someonelse20/Simple-FC/production/BOM.csv

Reference | Qty | Value | DNP | Exclude from BOM | Exclude from Board | Exclude from Simulation | Exclude from Position Files | Footprint | Datasheet | MPN
SW1 | 1 | SW_Push |  |  |  |  | ${EXCLUDE_FROM_POS_FILES} | Button_Switch_SMD:SW_Push_SPST_NO_Alps_SKRK |  | SKRKAEE020
C1,C2 | 2 | 33pF |  |  |  |  | ${EXCLUDE_FROM_POS_FILES} | Capacitor_SMD:C_0402_1005Metric |  | CL05C330JB5NNNC
C4,C10,C26,C28,C29 | 5 | 4.7uF |  |  |  |  | ${EXCLUDE_FROM_POS_FILES} | Capacitor_SMD:C_0402_1005Metric |  | GRM155R60J475ME47D
C5,C6,C7,C8,C9,C11,C12,C13,C14,C15,C16,C17,C18,C22,C23 | 15 | 0.1uF |  |  |  |  | ${EXCLUDE_FROM_POS_FILES} | Capacitor_SMD:C_0402_1005Metric |  | GRM155R71H104KE14D
C20,C21 | 2 | 1uF |  |  |  |  | ${EXCLUDE_FROM_POS_FILES} | Capacitor_SMD:C_0402_1005Metric |  | CL05A105KO5NNNC
C19 | 1 | 10uF |  |  |  |  | ${EXCLUDE_FROM_POS_FILES} | Capacitor_SMD:C_0603_1608Metric |  | GRM188R61A106ME69D
C24 | 1 | 47uF |  |  |  |  | ${EXCLUDE_FROM_POS_FILES} | Capacitor_SMD:C_0603_1608Metric |  | GRM188R60J476ME15D
C25 | 1 | 22uF |  |  |  |  | ${EXCLUDE_FROM_POS_FILES} | Capacitor_SMD:C_0603_1608Metric |  | C1608X5R0J226M080AC
J2 | 1 | Micro_SD_Card |  |  |  |  | ${EXCLUDE_FROM_POS_FILES} | Connector_Card:microSD_HC_Molex_47219-2001 | https://www.we-online.com/components/products/datasheet/693072010801.pdf | MSD-7-A
J8 | 1 | Conn_01x03 | DNP |  |  |  | ${EXCLUDE_FROM_POS_FILES} | Connector_PinHeader_2.54mm:PinHeader_1x03_P2.54mm_Vertical
J3,J4,J5,J7 | 4 | Conn_01x04 | DNP |  |  |  | ${EXCLUDE_FROM_POS_FILES} | Connector_PinHeader_2.54mm:PinHeader_1x04_P2.54mm_Vertical
J6 | 1 | Conn_01x05 | DNP |  |  |  | ${EXCLUDE_FROM_POS_FILES} | Connector_PinHeader_2.54mm:PinHeader_1x05_P2.54mm_Vertical
J1 | 1 | USB_C_Receptacle_USB2.0_14P |  |  |  |  | ${EXCLUDE_FROM_POS_FILES} | Connector_USB:USB_C_Receptacle_HRO_TYPE-C-31-M-12 | https://www.usb.org/sites/default/files/documents/usb_type-c.zip | UJ20-C-H-G-SMT-1-P16-TR
J9,J10 | 2 | Conn_01x01 | DNP |  |  |  | ${EXCLUDE_FROM_POS_FILES} | Connector_Wire:SolderWirePad_1x01_SMD_1x2mm
Y1 | 1 | 12MHz |  |  |  |  | ${EXCLUDE_FROM_POS_FILES} | Crystal:Crystal_SMD_3225-4Pin_3.2x2.5mm |  | ABM8-272-T3
D1,D2 | 2 | D_Schottky |  |  |  |  | ${EXCLUDE_FROM_POS_FILES} | Diode_SMD:D_SMA |  | SS210A
L1 | 1 | 1uH |  |  |  |  | ${EXCLUDE_FROM_POS_FILES} | Inductor_SMD:L_0805_2012Metric |  | DFE201210U-1R0M=P2
L2 | 1 | 3.3uH |  |  |  |  | ${EXCLUDE_FROM_POS_FILES} | Inductor_SMD:L_0805_2012Metric |  | AOTA-B201610S3R3-101-T
D3,D4 | 2 | LED |  |  |  |  | ${EXCLUDE_FROM_POS_FILES} | LED_SMD:LED_0603_1608Metric |  | LTST-C190GKT,LTST-C190KRKT
U1 | 1 | RP2350A |  |  |  |  | ${EXCLUDE_FROM_POS_FILES} | Package_DFN_QFN:QFN-60-1EP_7x7mm_P0.4mm_EP3.4x3.4mm | https://datasheets.raspberrypi.com/rp2350/rp2350-datasheet.pdf | RP2350A
U3 | 1 | LSM6DSM |  |  |  |  | ${EXCLUDE_FROM_POS_FILES} | Package_LGA:LGA-14_3x2.5mm_P0.5mm_LayoutBorder3x4y | https://www.st.com/resource/en/datasheet/lsm6dsm.pdf | LSM6DSMTR
U2 | 1 | MMC5983MA |  |  |  |  | ${EXCLUDE_FROM_POS_FILES} | Package_LGA:LGA-16_3x3mm_P0.5mm | https://www.memsic.com/Public/Uploads/uploadfile/files/20220119/MMC5983MADatasheetRevA.pdf | MMC5983MA
U4 | 1 | BMP384 |  |  |  |  | ${EXCLUDE_FROM_POS_FILES} | Package_LGA:ST_HLGA-10_2x2mm_P0.5mm_LayoutBorder3x2y | https://www.bosch-sensortec.com/media/boschsensortec/downloads/datasheets/bst-bmp384-ds003.pdf | BMP384
U6 | 1 | W25Q128JVS |  |  |  |  | ${EXCLUDE_FROM_POS_FILES} | Package_SON:Winbond_USON-8-1EP_3x2mm_P0.5mm_EP0.2x1.6mm | https://www.winbond.com/resource-files/w25q128jv_dtr%20revc%2003272018%20plus.pdf | W25Q128JVSIQ TR
U5 | 1 | TPS631000 |  |  |  |  | ${EXCLUDE_FROM_POS_FILES} | Package_TO_SOT_SMD:SOT-583-8 | https://www.ti.com/lit/ds/symlink/tps631000.pdf | TPS631000DRLR
R1,R2 | 2 | 5.1K |  |  |  |  | ${EXCLUDE_FROM_POS_FILES} | Resistor_SMD:R_0402_1005Metric |  | RC0402FR-075K1L
R3,R5,R20,R21 | 4 | 1K |  |  |  |  | ${EXCLUDE_FROM_POS_FILES} | Resistor_SMD:R_0402_1005Metric |  | ERJ-2RKF1001X
R4,R6,R7,R8,R9,R10,R11 | 7 | 10K |  |  |  |  | ${EXCLUDE_FROM_POS_FILES} | Resistor_SMD:R_0402_1005Metric |  | RC0402FR-0710KL
R12 | 1 | 511K |  |  |  |  | ${EXCLUDE_FROM_POS_FILES} | Resistor_SMD:R_0402_1005Metric |  | RC0402FR-13511KL
R13 | 1 | 91K |  |  |  |  | ${EXCLUDE_FROM_POS_FILES} | Resistor_SMD:R_0402_1005Metric |  | RK73H1ETTP9102F
R14,R16 | 2 | 100K |  |  |  |  | ${EXCLUDE_FROM_POS_FILES} | Resistor_SMD:R_0402_1005Metric |  | RC0402FR-07100KL
R15 | 1 | 33 |  |  |  |  | ${EXCLUDE_FROM_POS_FILES} | Resistor_SMD:R_0402_1005Metric |  | RC0402FR-0733RL
R17 | 1 | 150K |  |  |  |  | ${EXCLUDE_FROM_POS_FILES} | Resistor_SMD:R_0402_1005Metric |  | CPF0402B150KE1
R18,R19 | 2 | 4.7K |  |  |  |  | ${EXCLUDE_FROM_POS_FILES} | Resistor_SMD:R_0402_1005Metric |  | RK73H1ETTP4701F
