someonelse20/Simple-FC/hardware/Simple-FC.kicad_pcb

## KiCad design hardware/Simple-FC.kicad_pcb (2026-11-06)

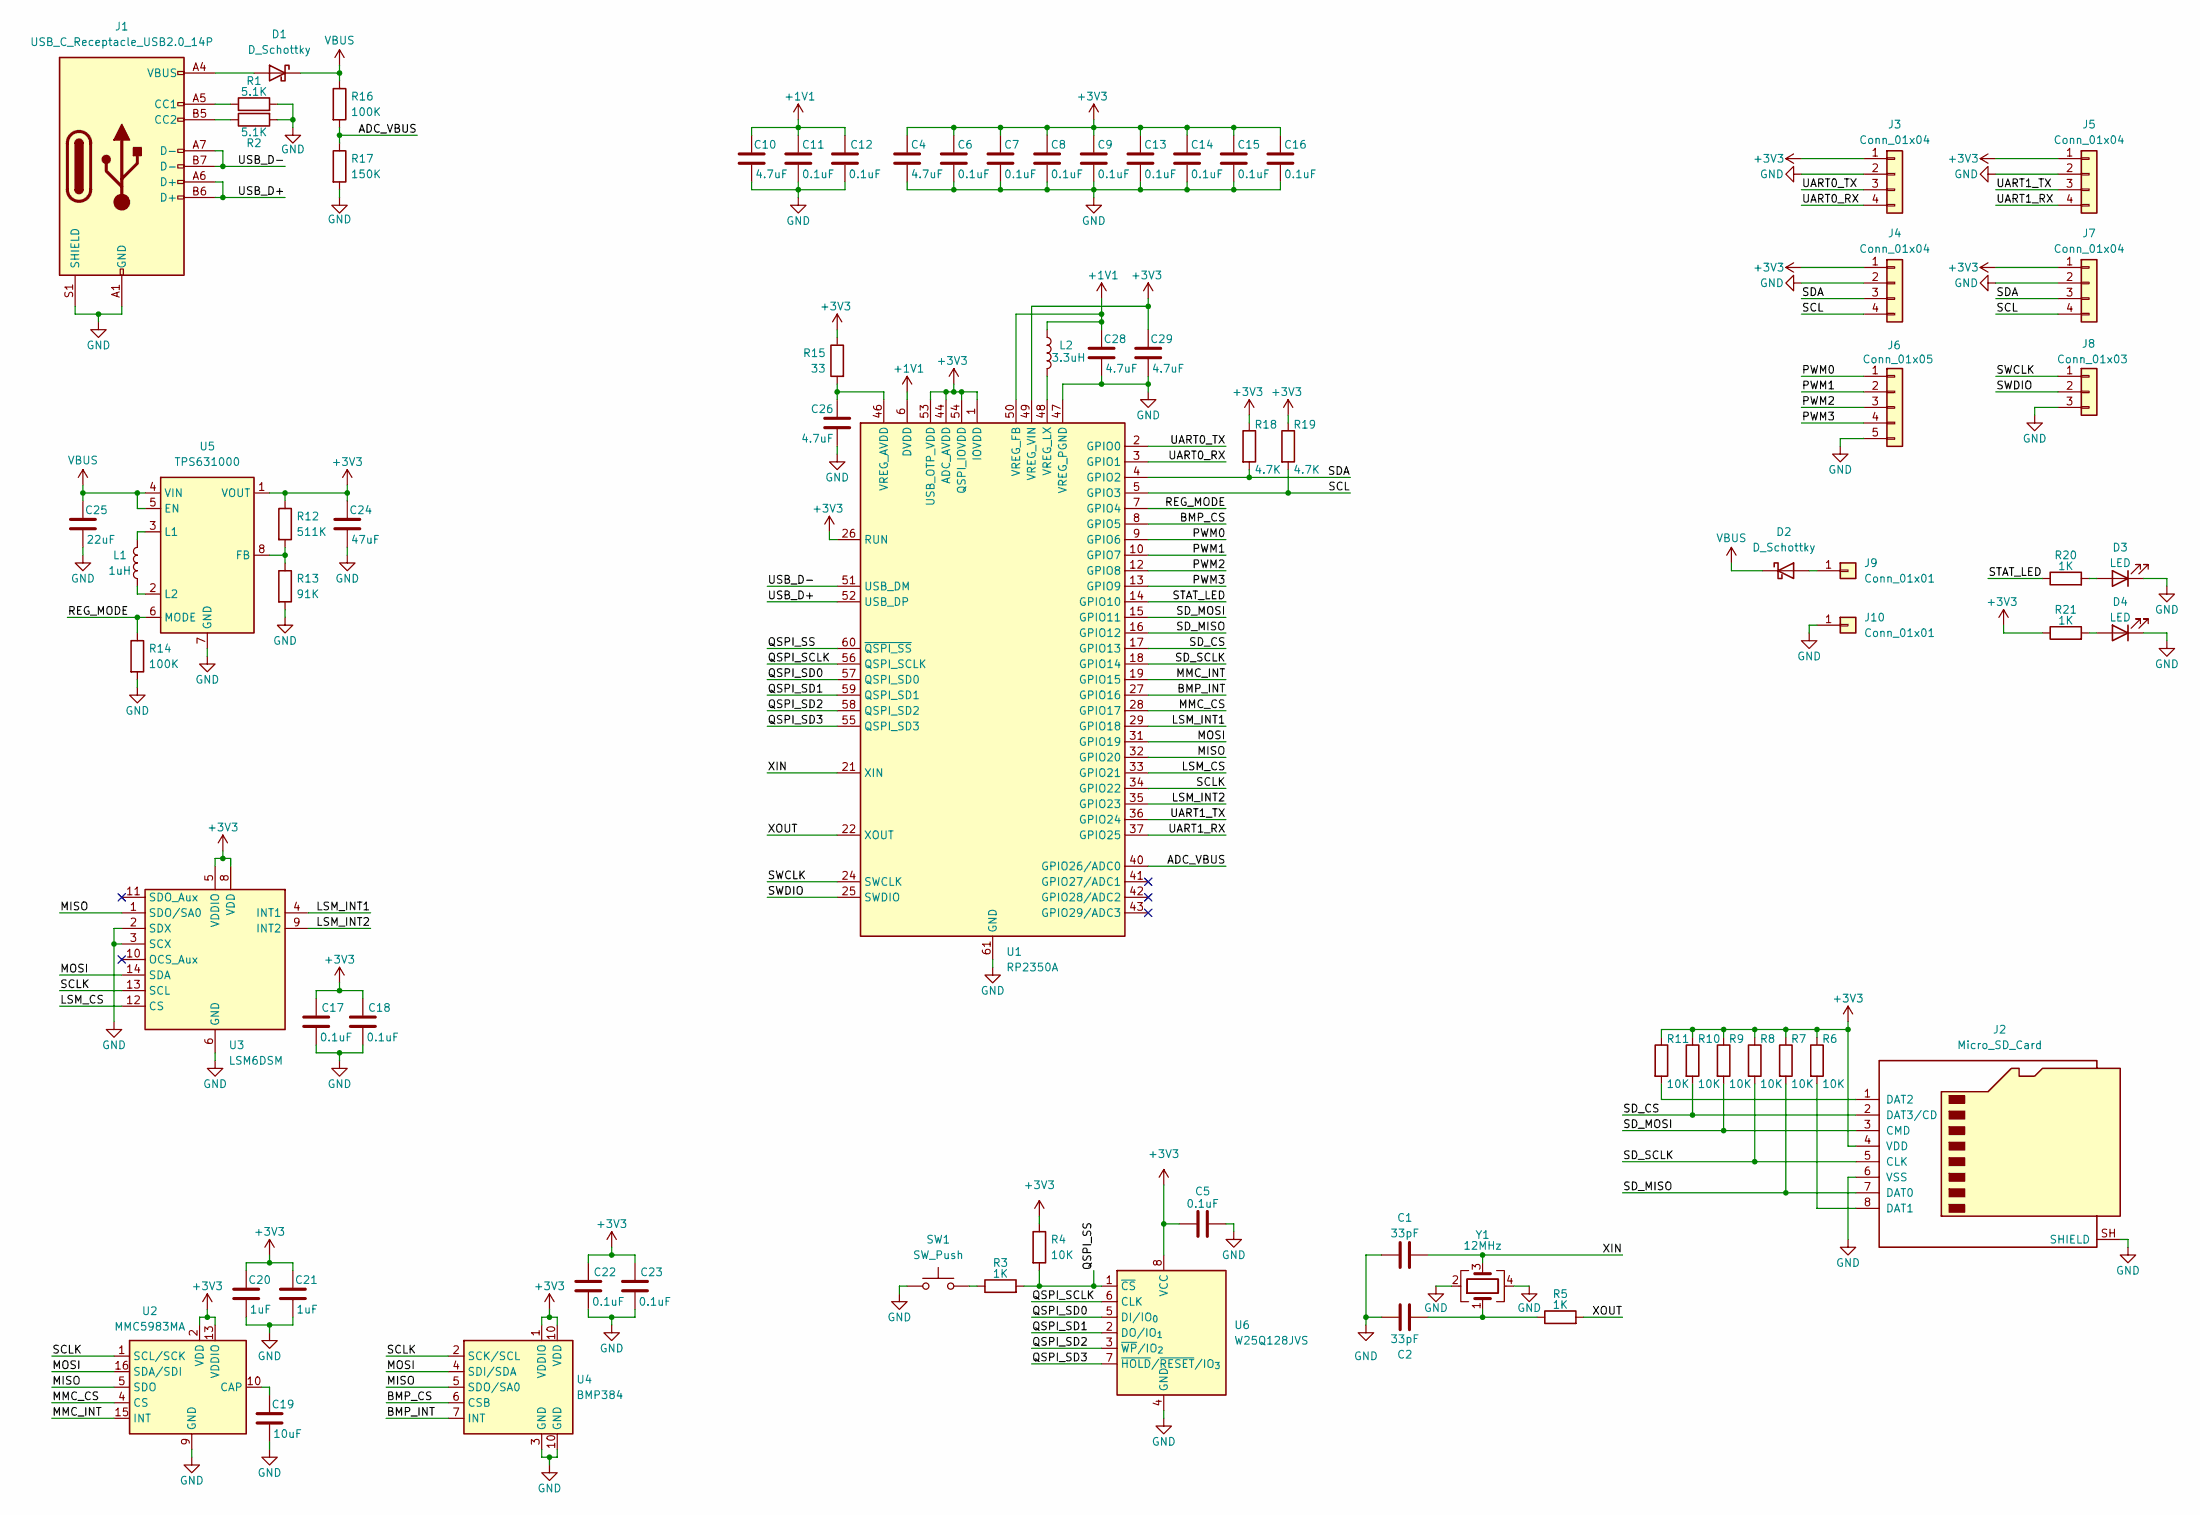
[picture p34: schematic Simple-FC.kicad_sch]

Parts:
C1, C2: 33pF; C_0402_1005Metric; MPN CL05C330JB5NNNC
C4, C10, C26, C28, C29: 4.7uF; C_0402_1005Metric; MPN GRM155R60J475ME47D
C5, C6, C7, C8, C9, C11, C12, C13, C14, C15, C16, C17, C18, C22, C23: 0.1uF; C_0402_1005Metric; MPN GRM155R71H104KE14D
C19: 10uF; C_0603_1608Metric; MPN GRM188R61A106ME69D
C20, C21: 1uF; C_0402_1005Metric; MPN CL05A105KO5NNNC
C24: 47uF; C_0603_1608Metric; MPN GRM188R60J476ME15D
C25: 22uF; C_0603_1608Metric; MPN C1608X5R0J226M080AC
D1, D2: D_Schottky; D_SMA; MPN SS210A
D3: LED; LED_0603_1608Metric; MPN LTST-C190GKT
D4: LED; LED_0603_1608Metric; MPN LTST-C190KRKT
J1: USB_C_Receptacle_USB2.0_14P; USB_C_Receptacle_HRO_TYPE-C-31-M-12; MPN UJ20-C-H-G-SMT-1-P16-TR
J2: Micro_SD_Card; microSD_HC_Molex_47219-2001; MPN MSD-7-A
J3, J4, J5, J7: Conn_01x04; PinHeader_1x04_P2.54mm_Vertical
J6: Conn_01x05; PinHeader_1x05_P2.54mm_Vertical
J8: Conn_01x03; PinHeader_1x03_P2.54mm_Vertical
J9, J10: Conn_01x01; SolderWirePad_1x01_SMD_1x2mm
L1: 1uH; L_0805_2012Metric; MPN DFE201210U-1R0M=P2
L2: 3.3uH; L_0805_2012Metric; MPN AOTA-B201610S3R3-101-T
R1, R2: 5.1K; R_0402_1005Metric; MPN RC0402FR-075K1L
R3, R5, R20, R21: 1K; R_0402_1005Metric; MPN ERJ-2RKF1001X
R4, R6, R7, R8, R9, R10, R11: 10K; R_0402_1005Metric; MPN RC0402FR-0710KL
R12: 511K; R_0402_1005Metric; MPN RC0402FR-13511KL
R13: 91K; R_0402_1005Metric; MPN RK73H1ETTP9102F
R14, R16: 100K; R_0402_1005Metric; MPN RC0402FR-07100KL
R15: 33; R_0402_1005Metric; MPN RC0402FR-0733RL
R17: 150K; R_0402_1005Metric; MPN CPF0402B150KE1
R18, R19: 4.7K; R_0402_1005Metric; MPN RK73H1ETTP4701F
SW1: SW_Push; SW_Push_SPST_NO_Alps_SKRK; MPN SKRKAEE020
U1: RP2350A; QFN-60-1EP_7x7mm_P0.4mm_EP3.4x3.4mm; MPN RP2350A
U2: MMC5983MA; LGA-16_3x3mm_P0.5mm; MPN MMC5983MA
U3: LSM6DSM; LGA-14_3x2.5mm_P0.5mm_LayoutBorder3x4y; MPN LSM6DSMTR
U4: BMP384; ST_HLGA-10_2x2mm_P0.5mm_LayoutBorder3x2y; MPN BMP384
U5: TPS631000; SOT-583-8; MPN TPS631000DRLR
U6: W25Q128JVS; Winbond_USON-8-1EP_3x2mm_P0.5mm_EP0.2x1.6mm; MPN W25Q128JVSIQ TR
Y1: 12MHz; Crystal_SMD_3225-4Pin_3.2x2.5mm; MPN ABM8-272-T3

Connections:
+1V1: C10.1, C11.1, C12.1, C28.1, L2.1, U1.6 (DVDD), U1.23 (DVDD), U1.39 (DVDD), U1.50 (VREG_FB)
/ADC_VBUS: R16.2, R17.1, U1.40 (GPIO26/ADC0)
/BMP_CS: U1.8 (GPIO5), U4.6 (CSB)
/BMP_INT: U1.27 (GPIO16), U4.7 (INT)
/LSM_CS: U1.33 (GPIO21), U3.12 (CS)
/LSM_INT1: U1.29 (GPIO18), U3.4 (INT1)
/LSM_INT2: U1.35 (GPIO23), U3.9 (INT2)
/MISO: U1.32 (GPIO20), U2.5 (SDO), U3.1 (SDO/SA0), U4.5 (SDO/SA0)
/MMC_CS: U1.28 (GPIO17), U2.4 (CS)
/MMC_INT: U1.19 (GPIO15), U2.15 (INT)
/MOSI: U1.31 (GPIO19), U2.16 (SDA/SDI), U3.14 (SDA), U4.4 (SDI/SDA)
/PWM0: J6.1, U1.9 (GPIO6)
/PWM1: J6.2, U1.10 (GPIO7)
/PWM2: J6.3, U1.12 (GPIO8)
/PWM3: J6.4, U1.13 (GPIO9)
/QSPI_SCLK: U1.56 (QSPI_SCLK), U6.6 (CLK)
/QSPI_SD0: U1.57 (QSPI_SD0), U6.5 (DI/IO_{0})
/QSPI_SD1: U1.59 (QSPI_SD1), U6.2 (DO/IO_{1})
/QSPI_SD2: U1.58 (QSPI_SD2), U6.3 (~WP/IO_{2})
/QSPI_SD3: U1.55 (QSPI_SD3), U6.7 (~HOLD/~RESET/IO_{3})
/QSPI_SS: R3.2, R4.2, U1.60 (~QSPI_SS), U6.1 (~CS)
/REG_MODE: R14.1, U1.7 (GPIO4), U5.6 (MODE)
/SCL: J4.4, J7.4, R19.2, U1.5 (GPIO3)
/SCLK: U1.34 (GPIO22), U2.1 (SCL/SCK), U3.13 (SCL), U4.2 (SCK/SCL)
/SDA: J4.3, J7.3, R18.2, U1.4 (GPIO2)
/SD_CS: J2.2 (DAT3/CD), R10.2, U1.17 (GPIO13)
/SD_MISO: J2.7 (DAT0), R7.2, U1.16 (GPIO12)
/SD_MOSI: J2.3 (CMD), R9.2, U1.15 (GPIO11)
/SD_SCLK: J2.5 (CLK), R8.2, U1.18 (GPIO14)
/STAT_LED: R20.1, U1.14 (GPIO10)
/SWCLK: J8.1, U1.24 (SWCLK)
/SWDIO: J8.2, U1.25 (SWDIO)
/UART0_RX: J3.4, U1.3 (GPIO1)
/UART0_TX: J3.3, U1.2 (GPIO0)
/UART1_RX: J5.4, U1.37 (GPIO25)
/UART1_TX: J5.3, U1.36 (GPIO24)
/USB_D+: J1.A6 (D+), J1.B6 (D+), U1.52 (USB_DP)
/USB_D-: J1.A7 (D-), J1.B7 (D-), U1.51 (USB_DM)
/XIN: C1.2, U1.21 (XIN), Y1.3
/XOUT: R5.2, U1.22 (XOUT)
unnamed: C2.1, R5.1, Y1.1
unnamed: D1.2 (A), J1.A4 (VBUS), J1.A9 (VBUS), J1.B4 (VBUS), J1.B9 (VBUS)
unnamed: D2.2 (A), J9.1 (Pin_1_1)
unnamed: D3.2 (A), R20.2
unnamed: D4.2 (A), R21.2
unnamed: J1.A5 (CC1), R1.1
unnamed: J1.B5 (CC2), R2.1
unnamed: J2.8 (DAT1), R6.2
unnamed: J2.1 (DAT2), R11.2
unnamed: R3.1, SW1.2
unnamed: C26.1, R15.2, U1.46 (VREG_AVDD)
unnamed: L2.2, U1.48 (VREG_LX)
unnamed: C19.1, U2.10 (CAP)
unnamed: R12.2, R13.1, U5.8 (FB)
unnamed: L1.1, U5.3 (L1)
unnamed: L1.2, U5.2 (L2)
VBUS: C25.1, D1.1 (K), D2.1 (K), R16.1, U5.4 (VIN), U5.5 (EN)

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
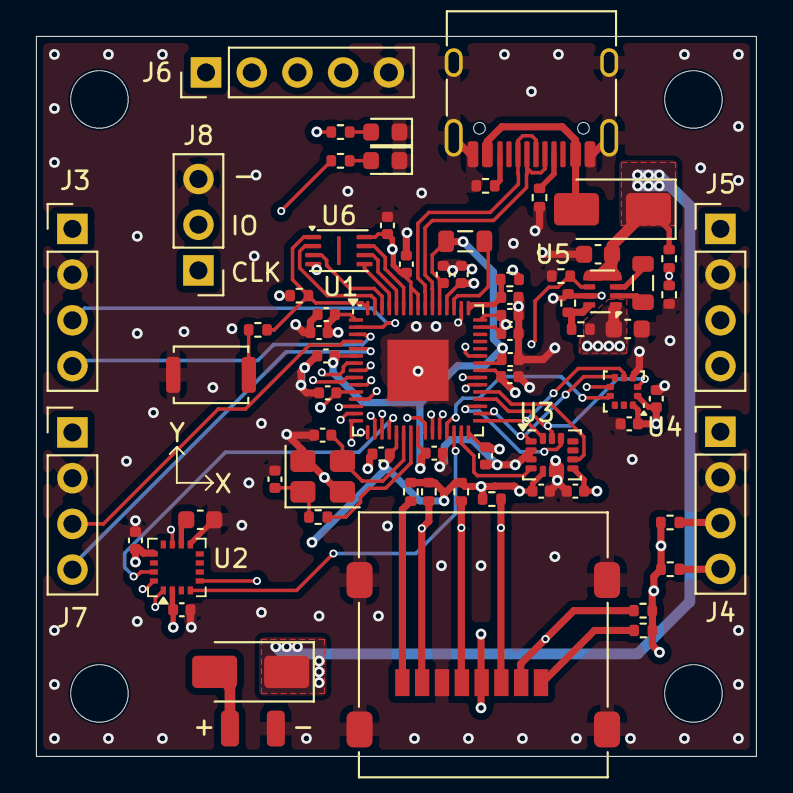
[picture p35: board Simple-FC.kicad_pcb from above]

Board: 4 copper layers, 40.0 x 40.0 mm, 72 parts (0 on the bottom side), 59 nets.
