someonelse20/Simple-FC/firmware/inc/main.h

#ifndef MAIN_H
#define MAIN_H

#define PIN_MISO 20
#define PIN_MOSI 19
#define PIN_SCLK 22

#define PIN_LED 10

#endif
