someonelse20/Simple-FC/firmware/src/lsm6dsm.rs

//! # SPI Example
//!
//! This application demonstrates how to use the SPI Driver to talk to a remote
//! SPI device.
//!
//!
//! It may need to be adapted to your particular board layout and/or pin
//! assignment.
//!
//! See the `Cargo.toml` file for Copyright and license details.

use embedded_hal::spi::SpiDevice;
use embedded_hal_bus::spi::ExclusiveDevice;
// Ensure we halt the program on panic (if we don't mention this crate it won't
// be linked)
use panic_halt as _;

// Alias for our HAL crate
use rp235x_hal as hal;

// Some things we need
use hal::clocks::Clock;
use hal::fugit::RateExtU32;

/// External high-speed crystal on the Raspberry Pi Pico 2 board is 12 MHz.
/// Adjust if your board has a different frequency
const XTAL_FREQ_HZ: u32 = 12_000_000u32;

/// Entry point to our bare-metal application.
///
/// The `#[hal::entry]` macro ensures the Cortex-M start-up code calls this function
/// as soon as all global variables and the spinlock are initialised.
///
/// The function configures the rp235x peripherals, then performs some example
/// SPI transactions, then goes to sleep.
fn main() -> ! {
    // Grab our singleton objects
    let mut pac = hal::pac::Peripherals::take().unwrap();

    // Set up the watchdog driver - needed by the clock setup code
    let mut watchdog = hal::Watchdog::new(pac.WATCHDOG);

    // Configure the clocks
    let clocks = hal::clocks::init_clocks_and_plls(
        XTAL_FREQ_HZ,
        pac.XOSC,
        pac.CLOCKS,
        pac.PLL_SYS,
        pac.PLL_USB,
        &mut pac.RESETS,
        &mut watchdog,
    )
    .unwrap();

    let mut timer = hal::Timer::new_timer0(pac.TIMER0, &mut pac.RESETS, &clocks);

    // The single-cycle I/O block controls our GPIO pins
    let sio = hal::Sio::new(pac.SIO);

    // Set the pins to their default state
    let pins = hal::gpio::Pins::new(
        pac.IO_BANK0,
        pac.PADS_BANK0,
        sio.gpio_bank0,
        &mut pac.RESETS,
    );

    // These are implicitly used by the spi driver if they are in the correct mode
    let spi_mosi = pins.gpio7.into_function::<hal::gpio::FunctionSpi>();
    let spi_miso = pins.gpio4.into_function::<hal::gpio::FunctionSpi>();
    let spi_sclk = pins.gpio6.into_function::<hal::gpio::FunctionSpi>();
    let spi_bus = hal::spi::Spi::<_, _, _, 8>::new(pac.SPI0, (spi_mosi, spi_miso, spi_sclk));

    // Exchange the uninitialised SPI driver for an initialised one
    let spi_bus = spi_bus.init(
        &mut pac.RESETS,
        clocks.peripheral_clock.freq(),
        16.MHz(),
        embedded_hal::spi::MODE_0,
    );

    let spi_cs = pins.gpio8.into_function::<hal::gpio::FunctionSioOutput>();
    let mut spi = ExclusiveDevice::new(spi_bus, spi_cs, &mut timer).unwrap();

    // Write out 0, ignore return value
    if spi.write(&[0]).is_ok() {
        // SPI write was successful
    };

    // Do a read+write at the same time. Data in `buffer` will be replaced with
    // the data read from the SPI device.
    let mut buffer: [u8; 4] = [1, 2, 3, 4];
    let transfer_success = spi.transfer_in_place(&mut buffer);
    #[allow(clippy::single_match)]
    match transfer_success {
        Ok(_) => {}  // Handle success
        Err(_) => {} // handle errors
    };

    loop {
        hal::arch::wfi();
    }
}

// End of file
