someonelse20/Simple-FC/(commit log)

2026-10-07 created kicad project
    [Simple-FC.kicad_pcb, Simple-FC.kicad_sch]
2026-10-07 picked imu and mcu
    [Simple-FC.kicad_sch]
2026-10-07 added magnetic sensor symbol
2026-10-07 selected parts
    [Simple-FC.kicad_sch]
2026-10-07 added decoupling caps
    [Simple-FC.kicad_sch]
2026-10-08 routed sensors and micro sd
    [Simple-FC.kicad_sch]
2026-10-08 switched to buck-boost reg
    [Simple-FC.kicad_sch]
2026-10-08 added gpio to regulator mode
    [Simple-FC.kicad_sch]
2026-10-08 routing mcu reg
    [Simple-FC.kicad_sch]
2026-10-08 finished mcu power circuit
    [Simple-FC.kicad_sch]
2026-10-08 wired mcu gpio
    [Simple-FC.kicad_sch]
2026-10-10 cleaned up schematic
    [Simple-FC.kicad_sch]
2026-10-10 started pcb layout
    [Simple-FC.kicad_pcb, Simple-FC.kicad_sch]
2026-10-10 drafted pcb layout
    [Simple-FC.kicad_pcb, Simple-FC.kicad_sch]
2026-10-11 routed mcu and power on pcb
    [Simple-FC.kicad_pcb, Simple-FC.kicad_sch]
2026-10-12 added power trace
2026-10-12 finished routing pcb
2026-10-12 fixed pin footprint
2026-10-12 touched up pcb
2026-10-12 added bom
2026-10-13 saved kicad
2026-11-06 changed kicad lock
2026-11-06 adding lsm6dsm driver
2026-11-06 changed spi to spi dma
